nivedjpnambiar/FT24-PDU-/Screenshot 2026-01-18 201632.png

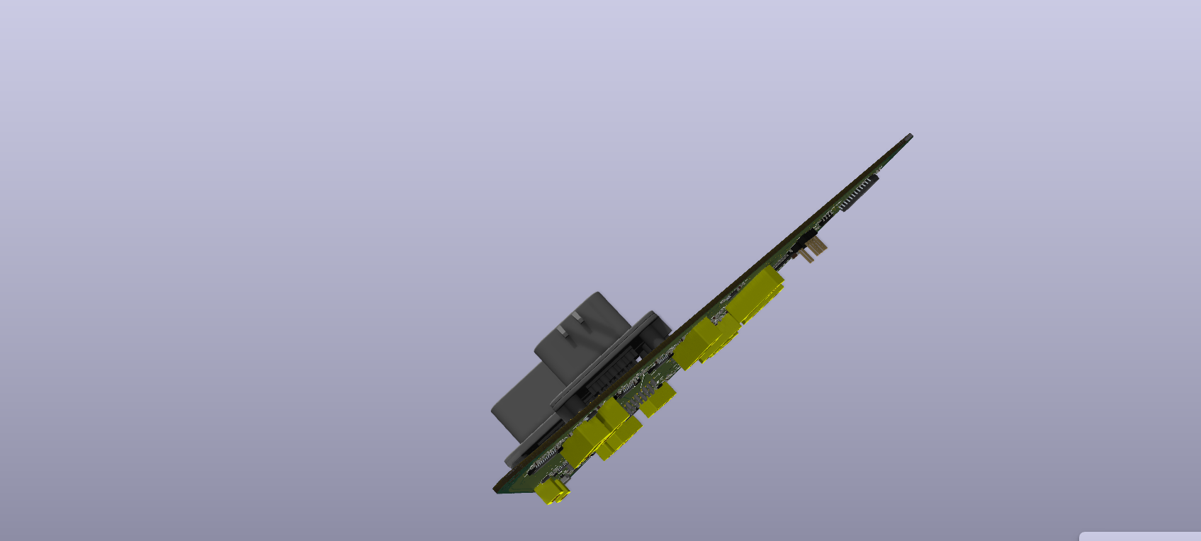
Screenshot 2026-01-18 201632.png
