nivedjpnambiar/FT24-PDU-/SETUP_INSTRUCTION_README!!!.md

Hey! 

Welcome to the Project I worked on during my time at FaSTTUBE, I designed the LV PDU ( Power Distribution Unit ) for the FT24 ( Fasttube´s formula student car for the 2023-2024 season ) 

----------------------------

KiCAD setup 

Once you download all the files, all files under KiCAD upload should be brought into one file 

Libraries.zip shuld be unpacked and placed into one file, this file should then be places in the main one file you have created which contains the KiCad project file 

-----------------------------------------

Code Setup 

Unpack pdu code.zip 

All main code can be found in the file Core 

All drivers and an STM32 Harware abstraction layer can be found in the Drivers file 

All IOC fies for microcontroller customiztion can be found directly after unpacking
