nivedjpnambiar/FT24-PDU-/STP files ( PDU neu )/AMpSEAL 35 stp/c-776164-1-f-3d.stp

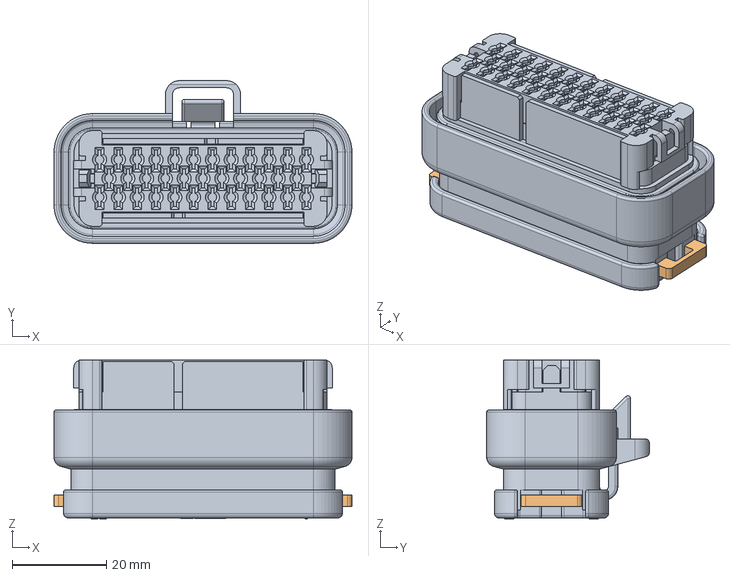
[picture p3: CAD file, 2026-01-18]
STP files ( PDU neu )/AMpSEAL 35 stp/c-776164-1-f-3d.stp
63.4 x 34.6 x 33.8 mm
