nivedjpnambiar/FT24-PDU-/STP files ( PDU neu )/PCA9535D,112.stp

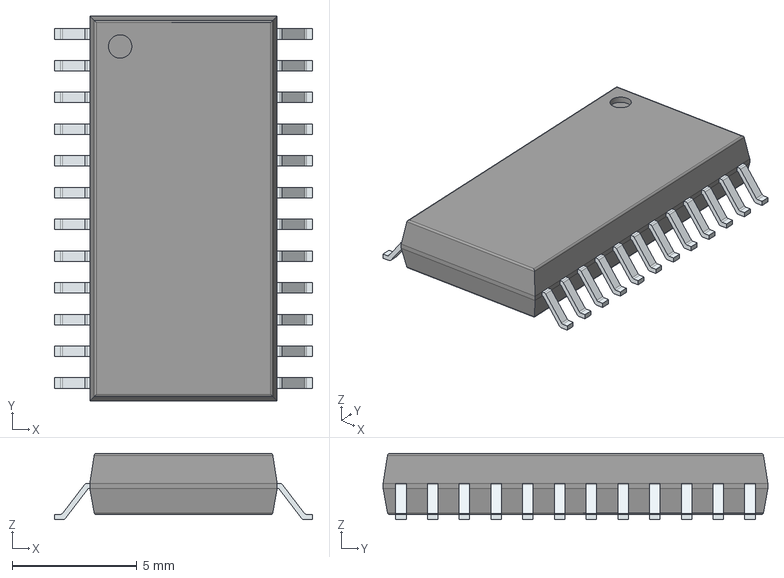
[picture p4: CAD file, 2026-01-18]
STP files ( PDU neu )/PCA9535D,112.stp
10.3 x 15.4 x 2.65 mm
PinsArrayLR
