nivedjpnambiar/FT24-PDU-/STP files ( PDU neu )/BTS70202EPAXUMA1.stp

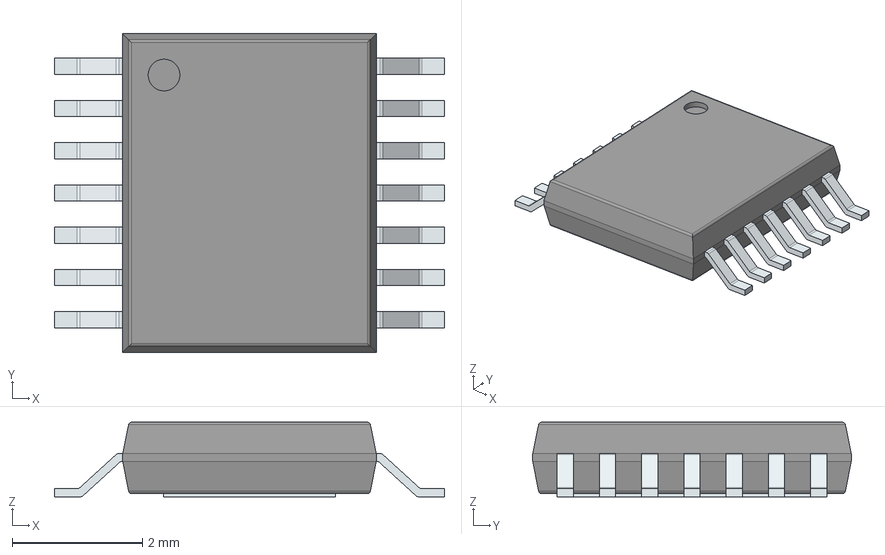
[picture p5: CAD file, 2026-01-18]
STP files ( PDU neu )/BTS70202EPAXUMA1.stp
6.00 x 4.90 x 1.15 mm
PinsArrayLR
ThermalPad
