nivedjpnambiar/FT24-PDU-/PDU FT24 MCU.ioc

Mcu.UserName=STM32F302RBTx
PA0.Signal=ADC1_IN1
PA1.Signal=ADC1_IN2
PA10.Signal=USART1_RX
PA11.Signal=CAN_RX
PA12.Signal=CAN_TX
PA13.Signal=SYS_JTMS-SWDIO
PA14.Signal=SYS_JTCK-SWCLK
PA15.Signal=I2C1_SCL
PA2.Signal=ADC1_IN3
PA3.Signal=ADC1_IN4
PA4.Signal=ADC2_IN1
PA5.Signal=ADC2_IN2
PA6.Signal=ADC2_IN3
PA7.Signal=ADC2_IN4
PA9.Signal=USART1_TX
PB0.Signal=S_TIM3_CH3
PB1.Signal=S_TIM3_CH4
PB12.GPIO_Label=DSEL 3
PB12.Signal=GPIO_Output
PB13.GPIO_Label=DSEL 4
PB13.Signal=GPIO_Output
PB14.GPIO_Label=DSEL 5
PB14.Signal=GPIO_Output
PB15.GPIO_Label=DSEL 6
PB15.Signal=GPIO_Output
PB3.Signal=S_TIM2_CH2
PB4.Signal=GPIO_Output
PB5.Signal=S_TIM3_CH2
PB7.Signal=I2C1_SDA
PB9.GPIO_Label=DSEL 7
PB9.Signal=GPIO_Output
PC0.Signal=ADCx_IN6
PC1.Signal=ADCx_IN7
PC2.Signal=ADCx_IN8
PC3.Signal=ADCx_IN9
PC6.GPIO_Label=STATUS_LED1
PC6.Signal=GPIO_Output
PC7.GPIO_Label=STATUS_LED2
PC7.Signal=GPIO_Output
PC8.GPIO_Label=STATUS_LED3
PC8.Signal=GPIO_Output
PC9.GPIO_Label=STATUS_LED4
PC9.Signal=GPIO_Output
PF0-OSC_IN.Signal=RCC_OSC_IN
PF1-OSC_OUT.Signal=RCC_OSC_OUT
