nivedjpnambiar/FT24-PDU-/(commit log)

2026-01-18 KiCad upload
    Hey!
    Looks like you found the KiCad file upload to my PDU, use the file PDU FT24 ( the KiCAD project file ) to open the whole project ( pcb and schematic )
    [1x10A_stage.kicad_sch, 1x20A_stage.kicad_sch, 2x5A_stage.kicad_sch, Aggregate ( PWM ) 1x20A.kicad_sch, Always On SDC.kicad_sch, BTS70202EPAXUMA1.stp, EBS CS Valve-Mode Valve.kicad_sch, EBS Valve 1-2.kicad_sch]
2026-01-18 PDU code
    Looks like you found the code to my PDU, after decompressing the files. Main .c and .h files caan be found under the file Core
    A complete STM32 Hardware abstraction layer can be found under Drivers
    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
2026-01-18 Libraries for KiCAD upload
    Hey, these are the libraries for the KiCAD project, this should be places in the main folder of the KiCad file
2026-01-19 Photos of the finished PCB
    Taken directly from KiCad`s 3d viewer, this is how my PCB looks like in real life!
